myriadrf/LimeFEA-mPCIe/hardware/1v0/Project Outputs/Pics/Stack calc/0.32-0.7-0.32 copl outer 50.png

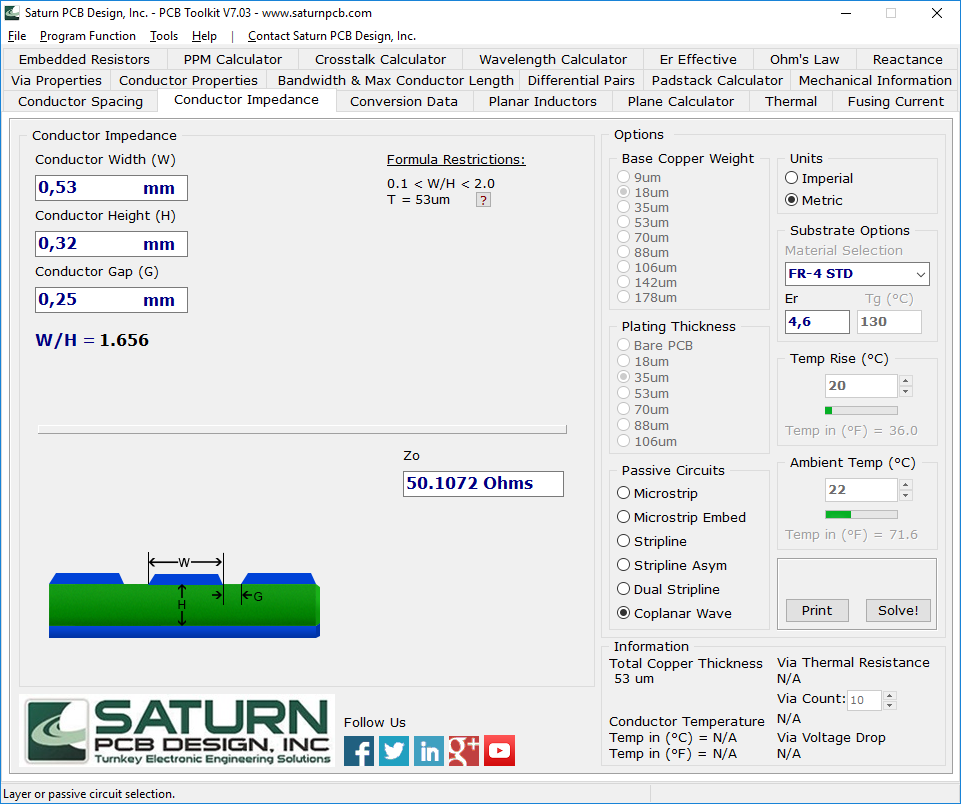
hardware/1v0/Project Outputs/Pics/Stack calc/0.32-0.7-0.32 copl outer 50.png
