myriadrf/LimeFEA-mPCIe/hardware/1v0/Project Outputs/Pics/Stack calc/0.32-0.7-0.32 strip inner 50.png

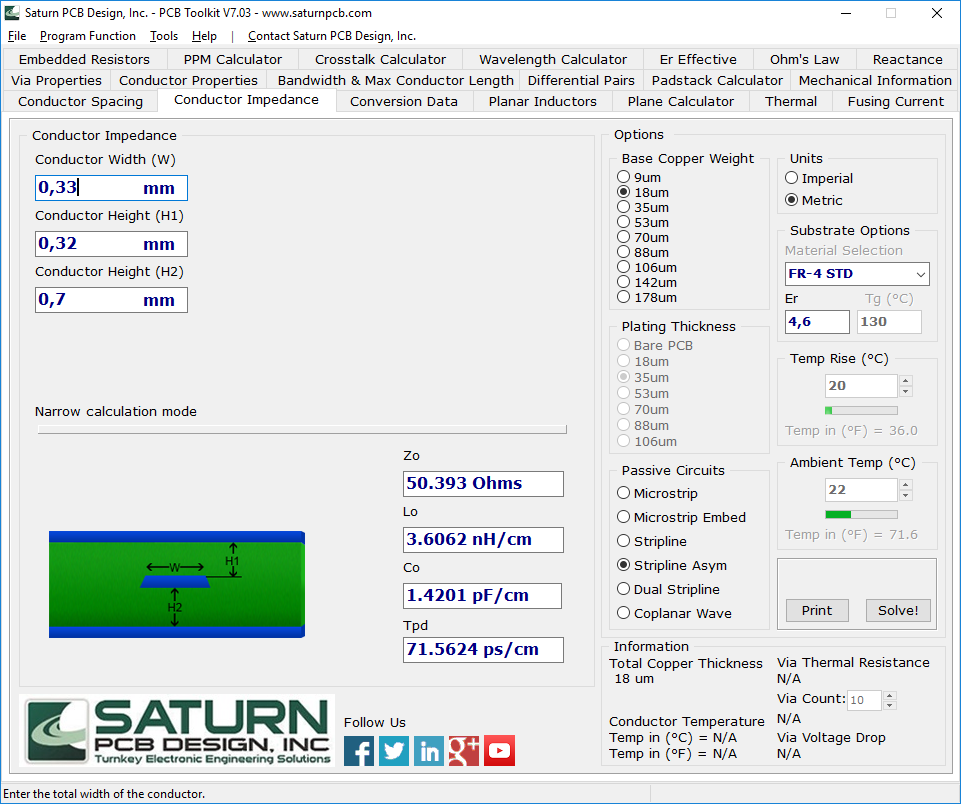
hardware/1v0/Project Outputs/Pics/Stack calc/0.32-0.7-0.32 strip inner 50.png
