myriadrf/LimeFEA-mPCIe/hardware/1v0/OutputJobs/BOM_Lime2.xlsx

Item # | Column=Comment | Column=Quantity | Column=Designator | Column=Description | Column=Comment | Column=Value | Column=U/P/TKE | Column=Name | Column=Designator | Column=Footprint | Column=Link | Column=Manufacturer | Column=Quantity
1
2
3
