myriadrf/LimeFEA-mPCIe/hardware/1v0/Project Outputs/BOM/BOM of 24070026 (LimeFEA-mPCIe_1v0) .xlsx

Reference Deal NO. |  | 24070026 |  |  |  | Orange: Need Special Attention
Part Number: |  | LimeFEA-mPCIe_1v0 |  | Green: Need Attention
Item | Qty | Reference | Manufacturer | Part No | Description |  | Note
1 | 6 | CJ1, CJ2, CJ5A, CJ5B, CJ6A, CJ6B | CHINA | AC-S01BH-U04RJ-F13-15 | Cable jumper |  | Substitutes
2 | 4 | CJ3A, CJ3B, CJ4A, CJ4B | CHINA | AC-U04RJ-U04RJ-F13-7.62 | Cable jumper |  | Substitutes
3 | 2 | 26B, C26A | YAGEO |  | CAP CER 1UF 10V X5R 0402
4 | 1 | C4 | YAGEO | SMD0603 | Capacitor |  | Substitutes
5 | 9 | C2, C3, C9, C10, C12, C15A, C15B, C18A, C18B | YAGEO | SMD0603 | Capacitor |  | Substitutes
6 | 4 | C23A, C23B, C24A, C24B | YAGEO | SMD0603 | Capacitor |  | Substitutes
7 | 1 | C1 | YAGEO | SMD0805 | Capacitor |  | Substitutes
8 | 1 | C11 | YAGEO | SMD0603 | Capacitor |  | Substitutes
9 | 1 | C7 | YAGEO | SMD0603 | Capacitor |  | Substitutes
10 | 18 | C13A, C13B, C14A, C14B, C16A, C16B, C17A, C17B, C19A, C19B, C20A, C20B, C21A, C21B, C22A, C22B, C25A, C25B | YAGEO | SMD0603 | Capacitor |  | Substitutes
11 | 1 | C8 | KEMET | CASE-D | Capacitor |  | Price based on T491D337K010AT
12 | 1 | E3 | / | Custom PCIe Bracket XTRX | CNC'ed enclosure component |  | Not quoted
13 | 1 | L2 | Taiyo | NRS5020T2R2NMGJ | Coil
14 | 1 | L3 | Taiyo | NRS5020T150MMGJ | Coil
15 | 4 | L4A, L4B, L5A, L5B | MURATA | LQW18AN22NG00D | Coil
16 | 12 | X3, X4, X11, X12, X13A, X13B, X14A, X14B, X15A, X15B, X16A, X16B | MOLEX | 734120110 | Connector (UMCC)
17 | 1 | X10 | MOLEX | 78864-1001 | Connector board to board
18 | 1 | X8 | Samtec | TSM-106-01-T-SH | Connector header male
19 | 1 | X1 | MOLEX | USB-microB | Connector microUSB-B
20 | 1 | X5 | JAE | MM60-52B1-G1 | Connector PCIe MiniCard |  | Price based on MM60-52B1-G1-R850
21 | 1 | X9 | JAE |  | Connector SIM micro card
22 | 4 | Z1A, Z1B, Z2A, Z2B | TDK | KNH16C105DB5TS | EMI Filter |  | Price based on YFF18PH0J105MT000N
23 | 1 | L1 | MURATA | BLM18PG181SN1D | Ferrite Bead EMIFIL
24 | 1 | X17 | CHINA |  | Headers & Wire Housings KK 100 Hdr FrLk Vert 02 Ckt Gold |  | Estimate, provide product images for the order
25 | 2 | U4A, U4B | Qorvo | SPF-5043Z | IC |  | Substitutes
26 | 1 | U1 | TI | TPS62130RG | IC
27 | 1 | U2 | onsemi | NCP5501DT50G | IC LDO fixed Vo
28 | 4 | U5A, U5B, U6A, U6B | Skyworks | SKY13286-359LF | IC RF SPDT Absorptive Switch
29 | 1 | J2` | YAGEO | SMD0603 | Jumper |  | Not fitted
30 | 2 | J1, J2 | Samtec | TSM-103-01-T-SH | Jumper 3 pin
31 | 2 | J1', J2' | CHINA | CYT1058 | Jumper Short Cup |  | Substitutes
32 | 2 | LED1, LED2 | LITE-ON | LTST-C190KGKT | LED GREEN
33 | 1 | LED3 | LITE-ON | LTST-C190KRKT | LED RED
34 | 2 | L6A, L6B | muRata |  | Power Inductors - SMD .22 UH 20% |  | LQW18ANR22G00D
35 | 1 | R6 | YAGEO | SMD0603 | Resistor
36 | 1 | R4 | YAGEO | SMD0603 | Resistor
37 | 1 | R5 | YAGEO | SMD0603 | Resistor
38 | 3 | R7, R8, R9 | YAGEO | SMD0603 | Resistor
39 | 2 | U3A, U3B | Qorvo |  | RF Amplifier .05-4GHz P1dB= 22dB Gain 26.4dB 5Volts
40 | 3 | Cover1, Cover2, Cover3 | Laird Technologies EMI | Screening shield cover BMI-S-202-C | Screening shield cover
41 | 3 | Shield1, Shield2, Shield3 | Laird Technologies EMI | Screening shield frame BMI-S-202-F | Screening shield frame
42 | 2 | E4, E5 | CHINA | AFBST090-440X532-000200 | Screw #4-40 |  | Substitutes
43 | 2 | E1, E2 | CHINA | ASMM19228 | Screw M2 |  | Substitutes
44 | 2 | X6, X7 | JAE | NT1R3000 | Stand-off nut PCIe MiniCard
45 | 1 | TG1 | Wakefield-Vette | PL-05-5-1016-H | Thermal gap filler
