myriadrf/LimeFEA-mPCIe/hardware/1v0/Project Outputs/LimeFEA-mPCIe_1v0_schematics.pdf

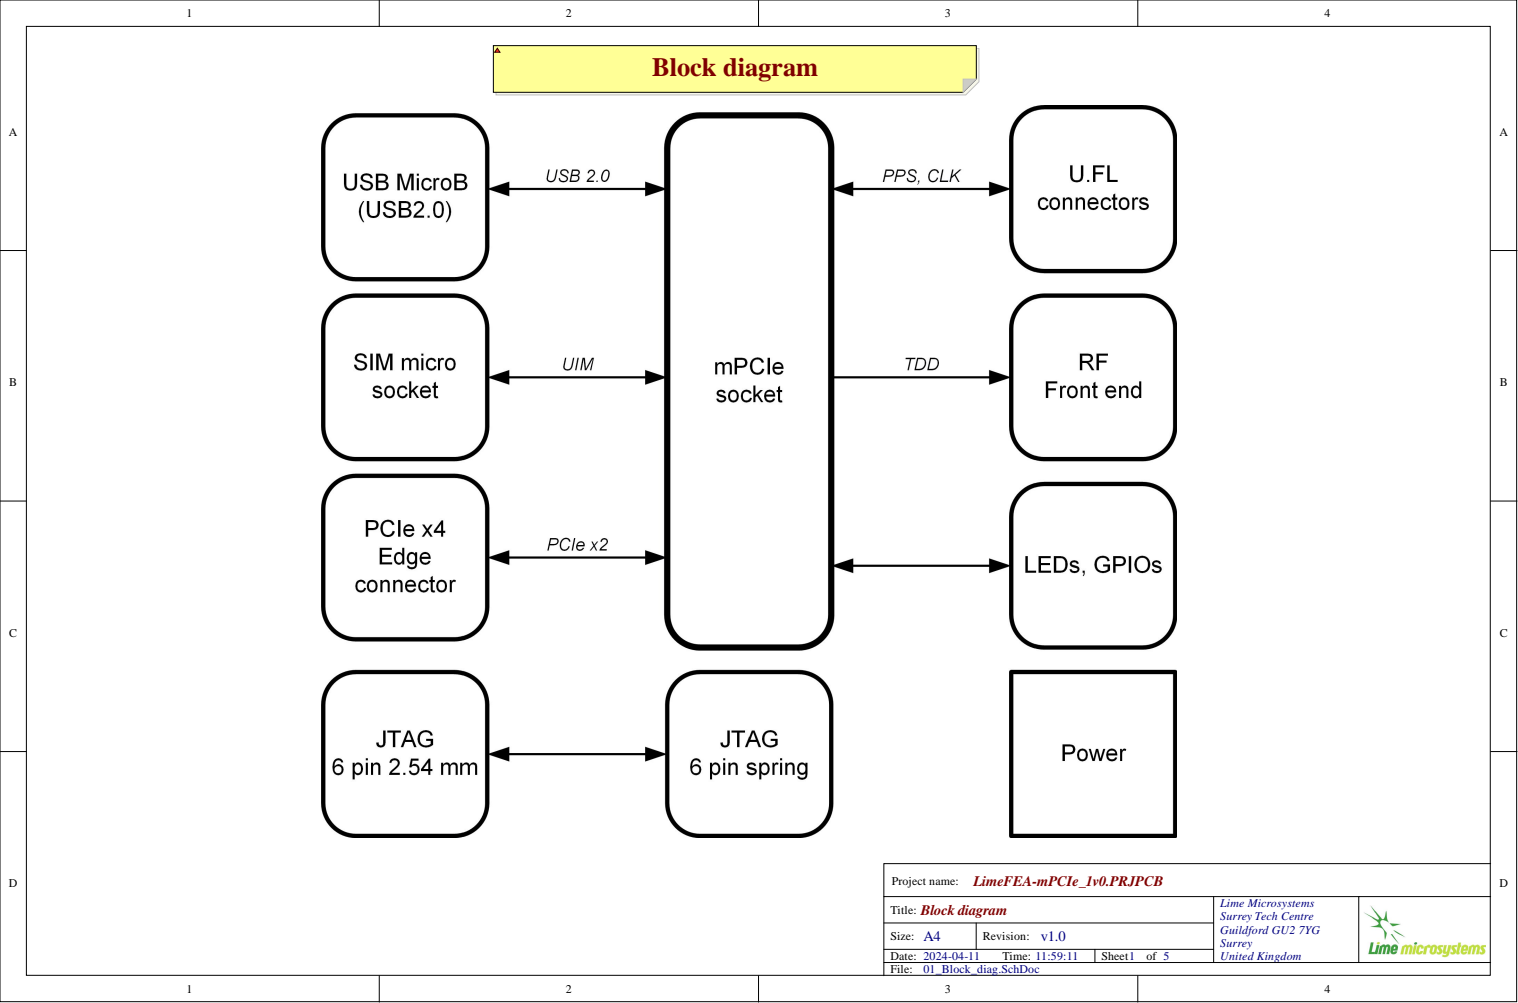
[picture p11: page 1]

Block diagram Title: | Lime Microsystems Surrey Tech Centre Guildford GU2 7YG Surrey United Kingdom

Size: A4 | Revision: v1.0
Date: 2024-04-11 Time: 11:59:11 | Sheet of 5

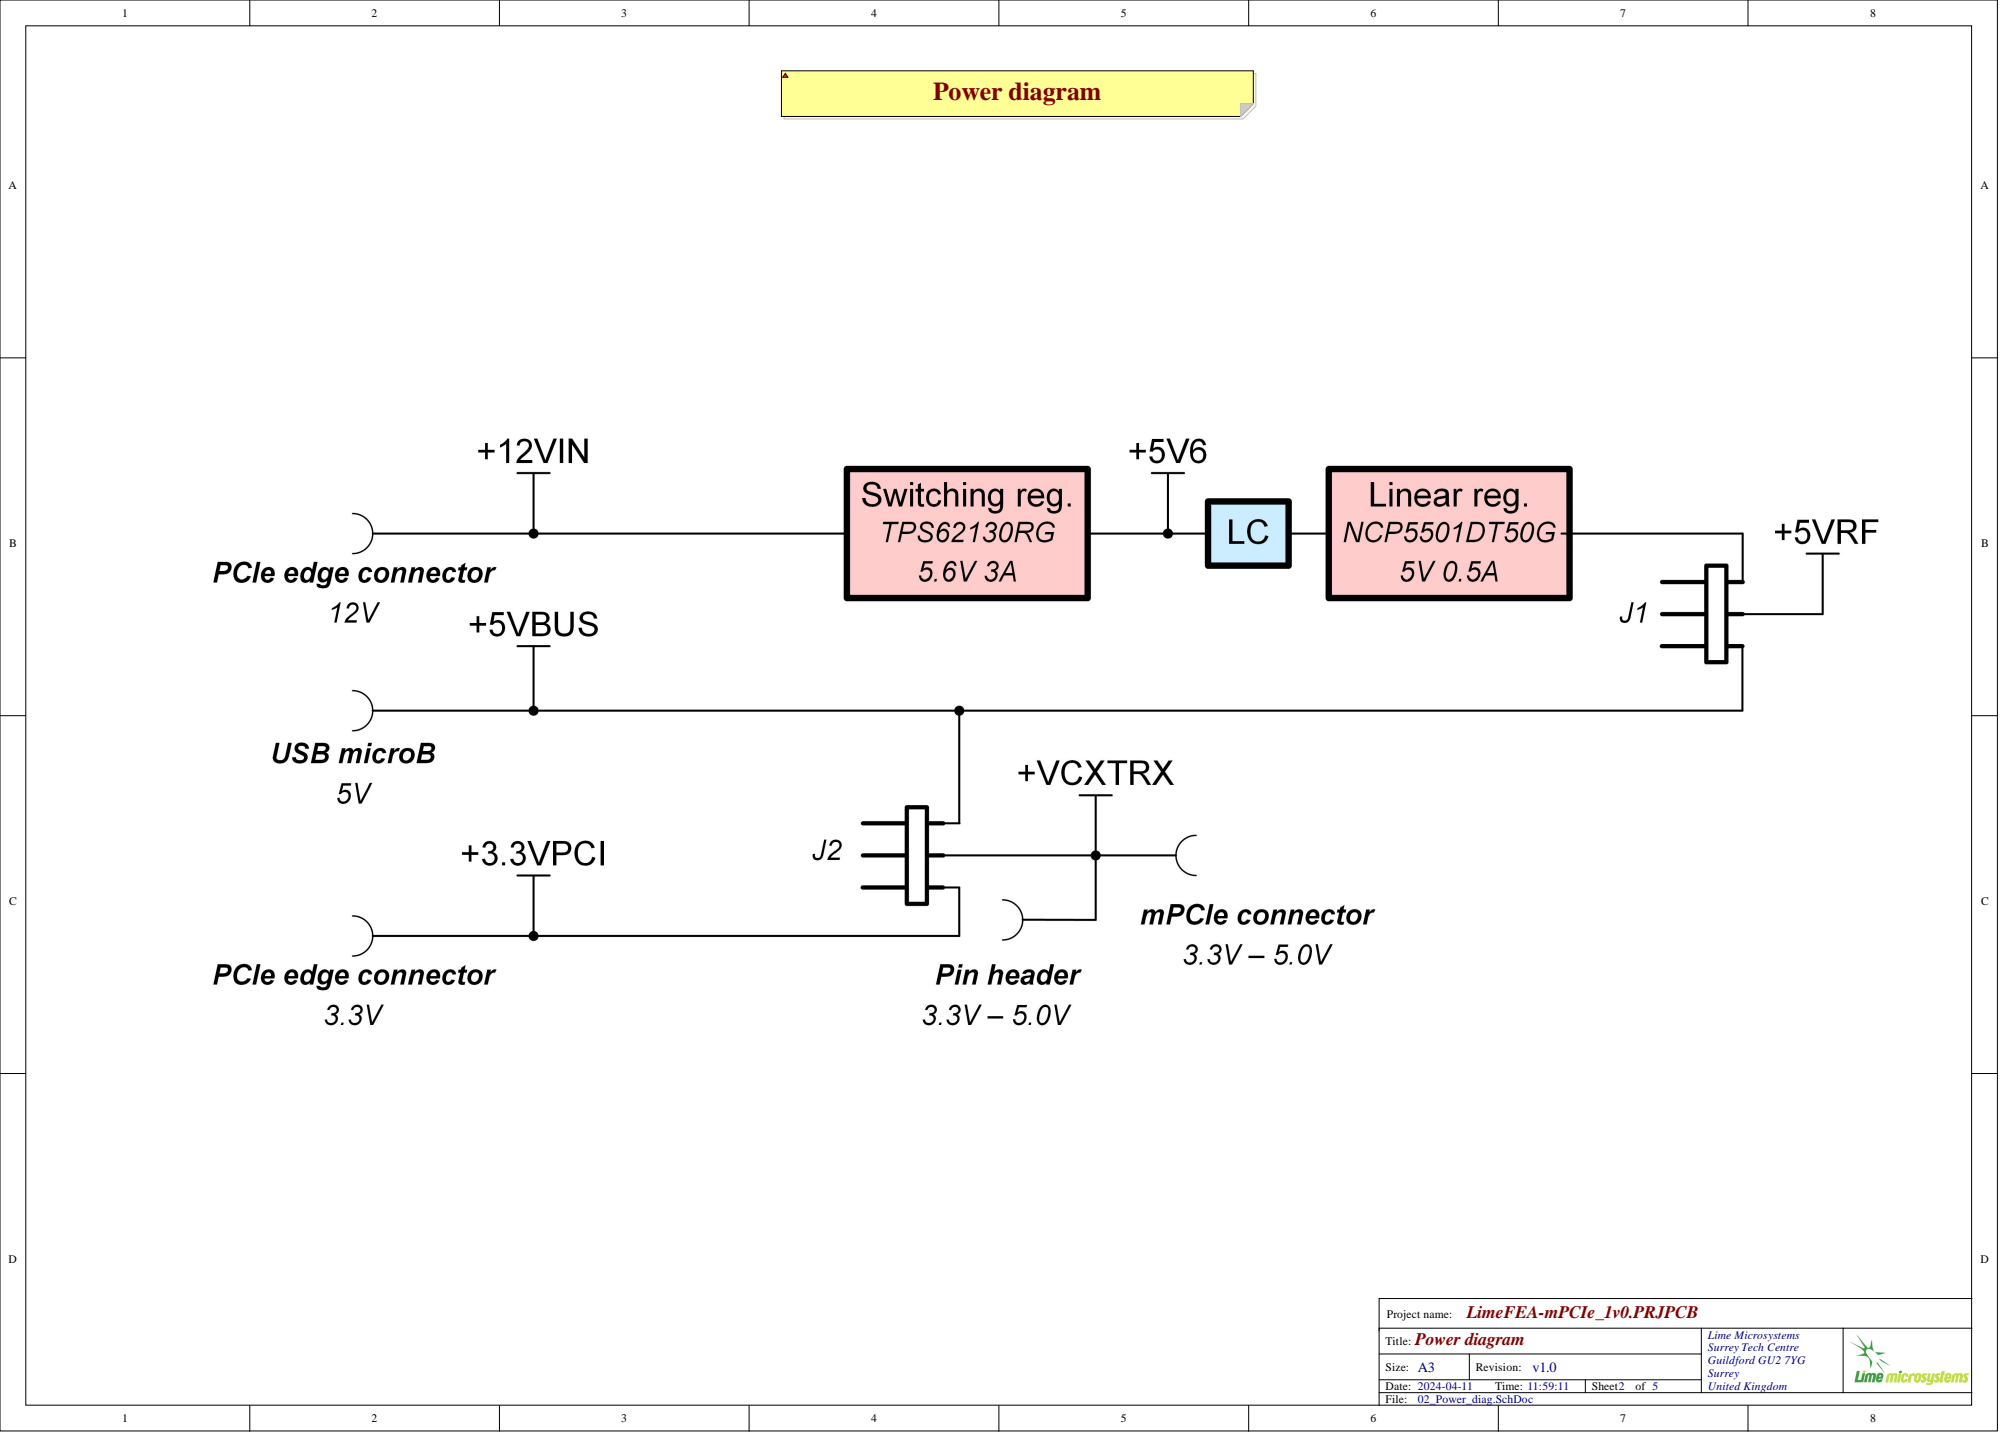
[picture p12: page 2]

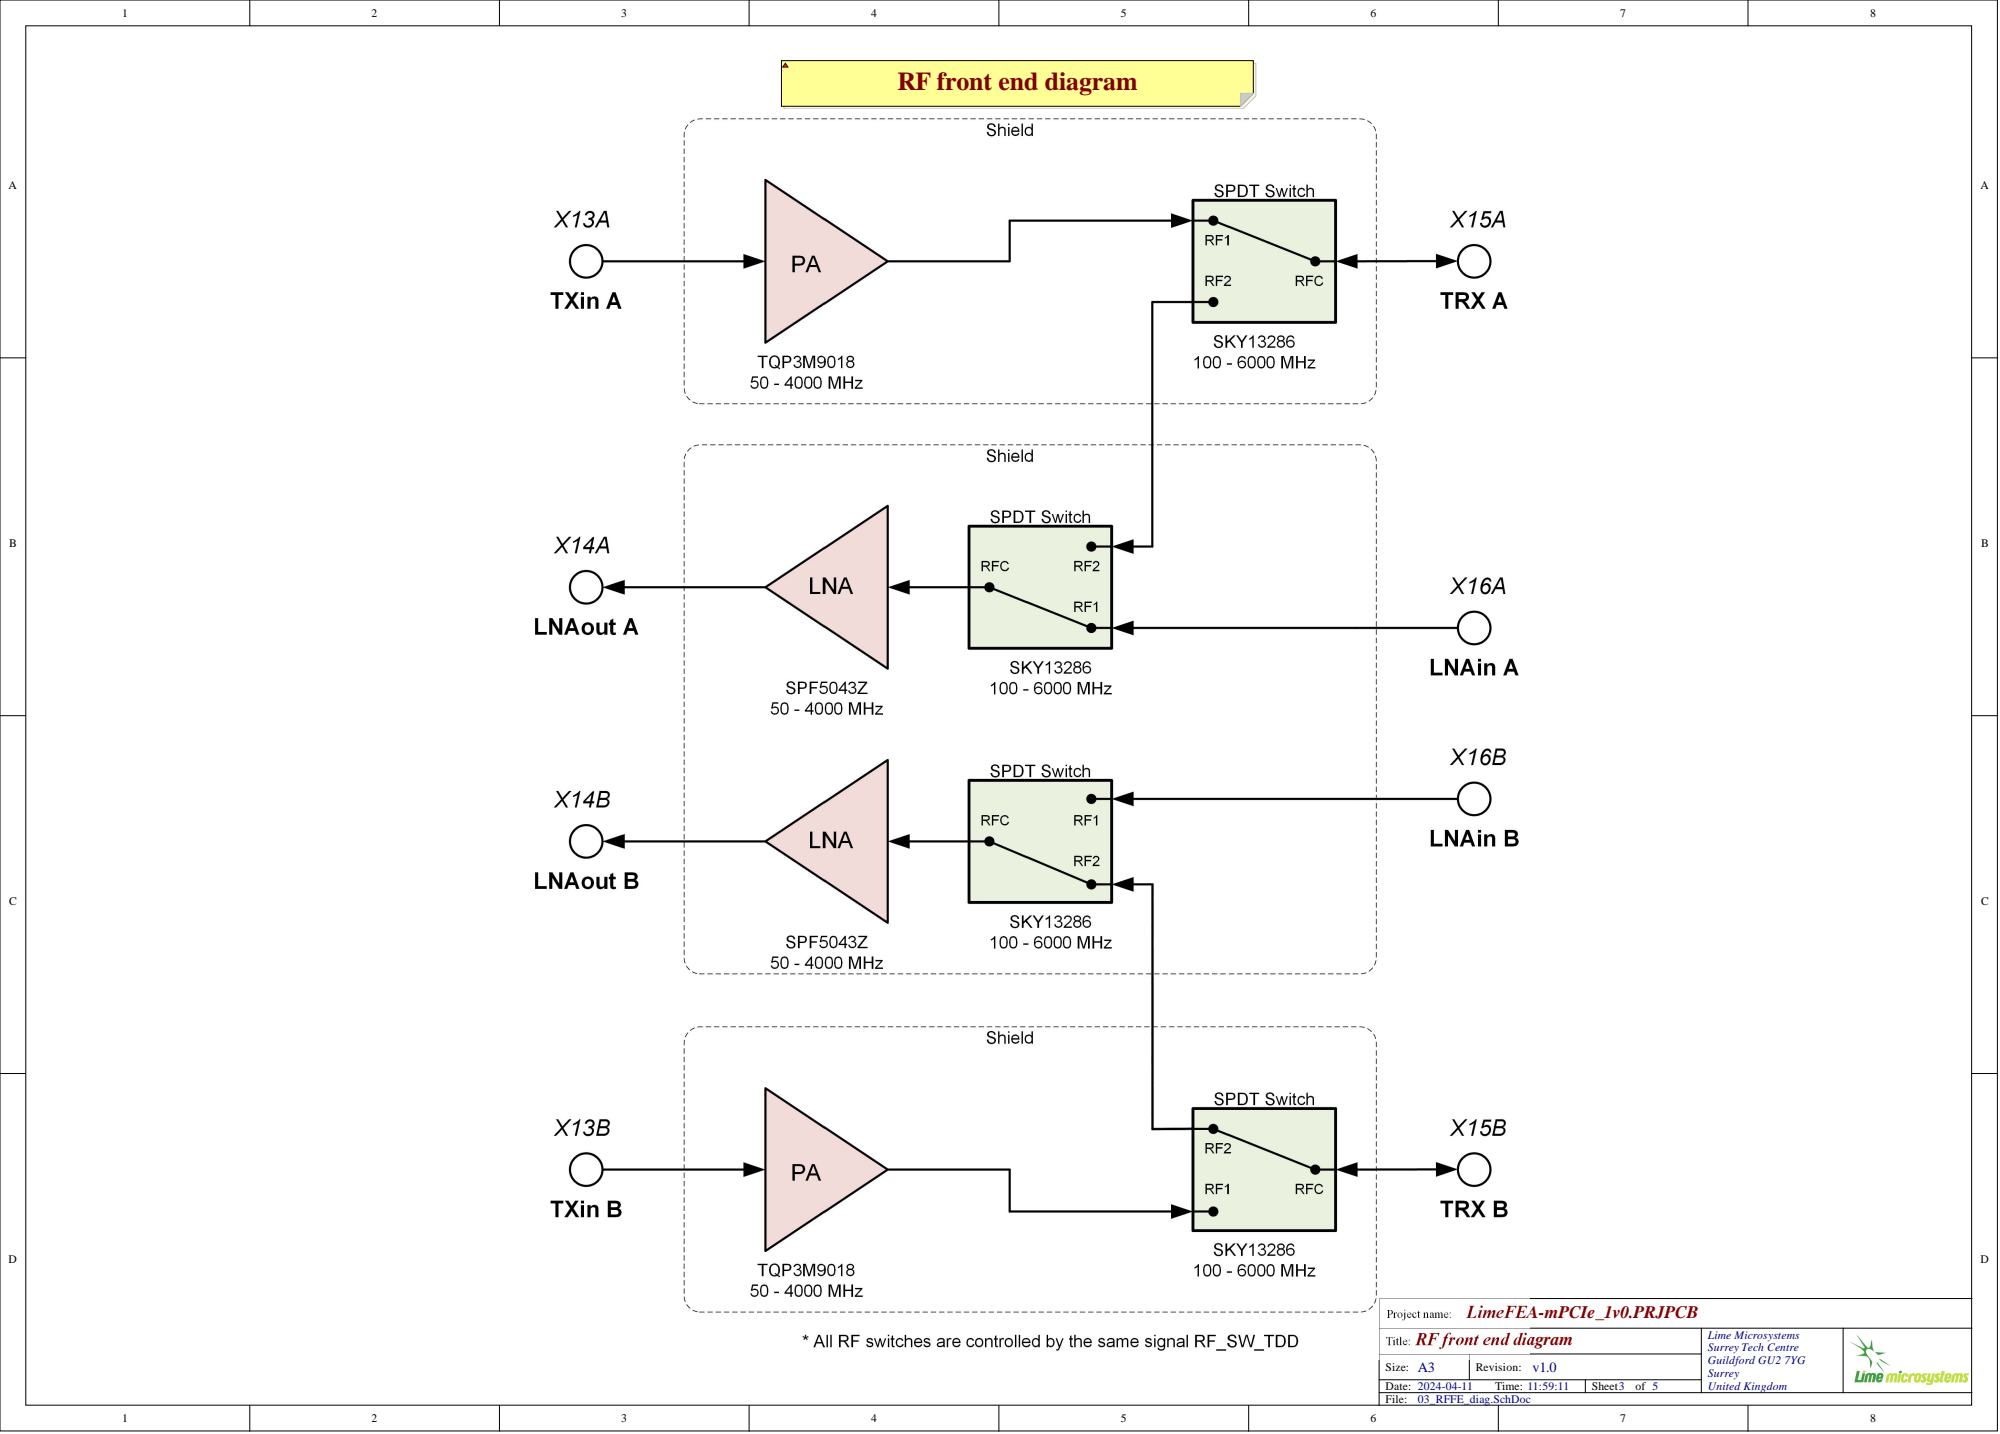
[picture p13: page 3]

RF front end diagram

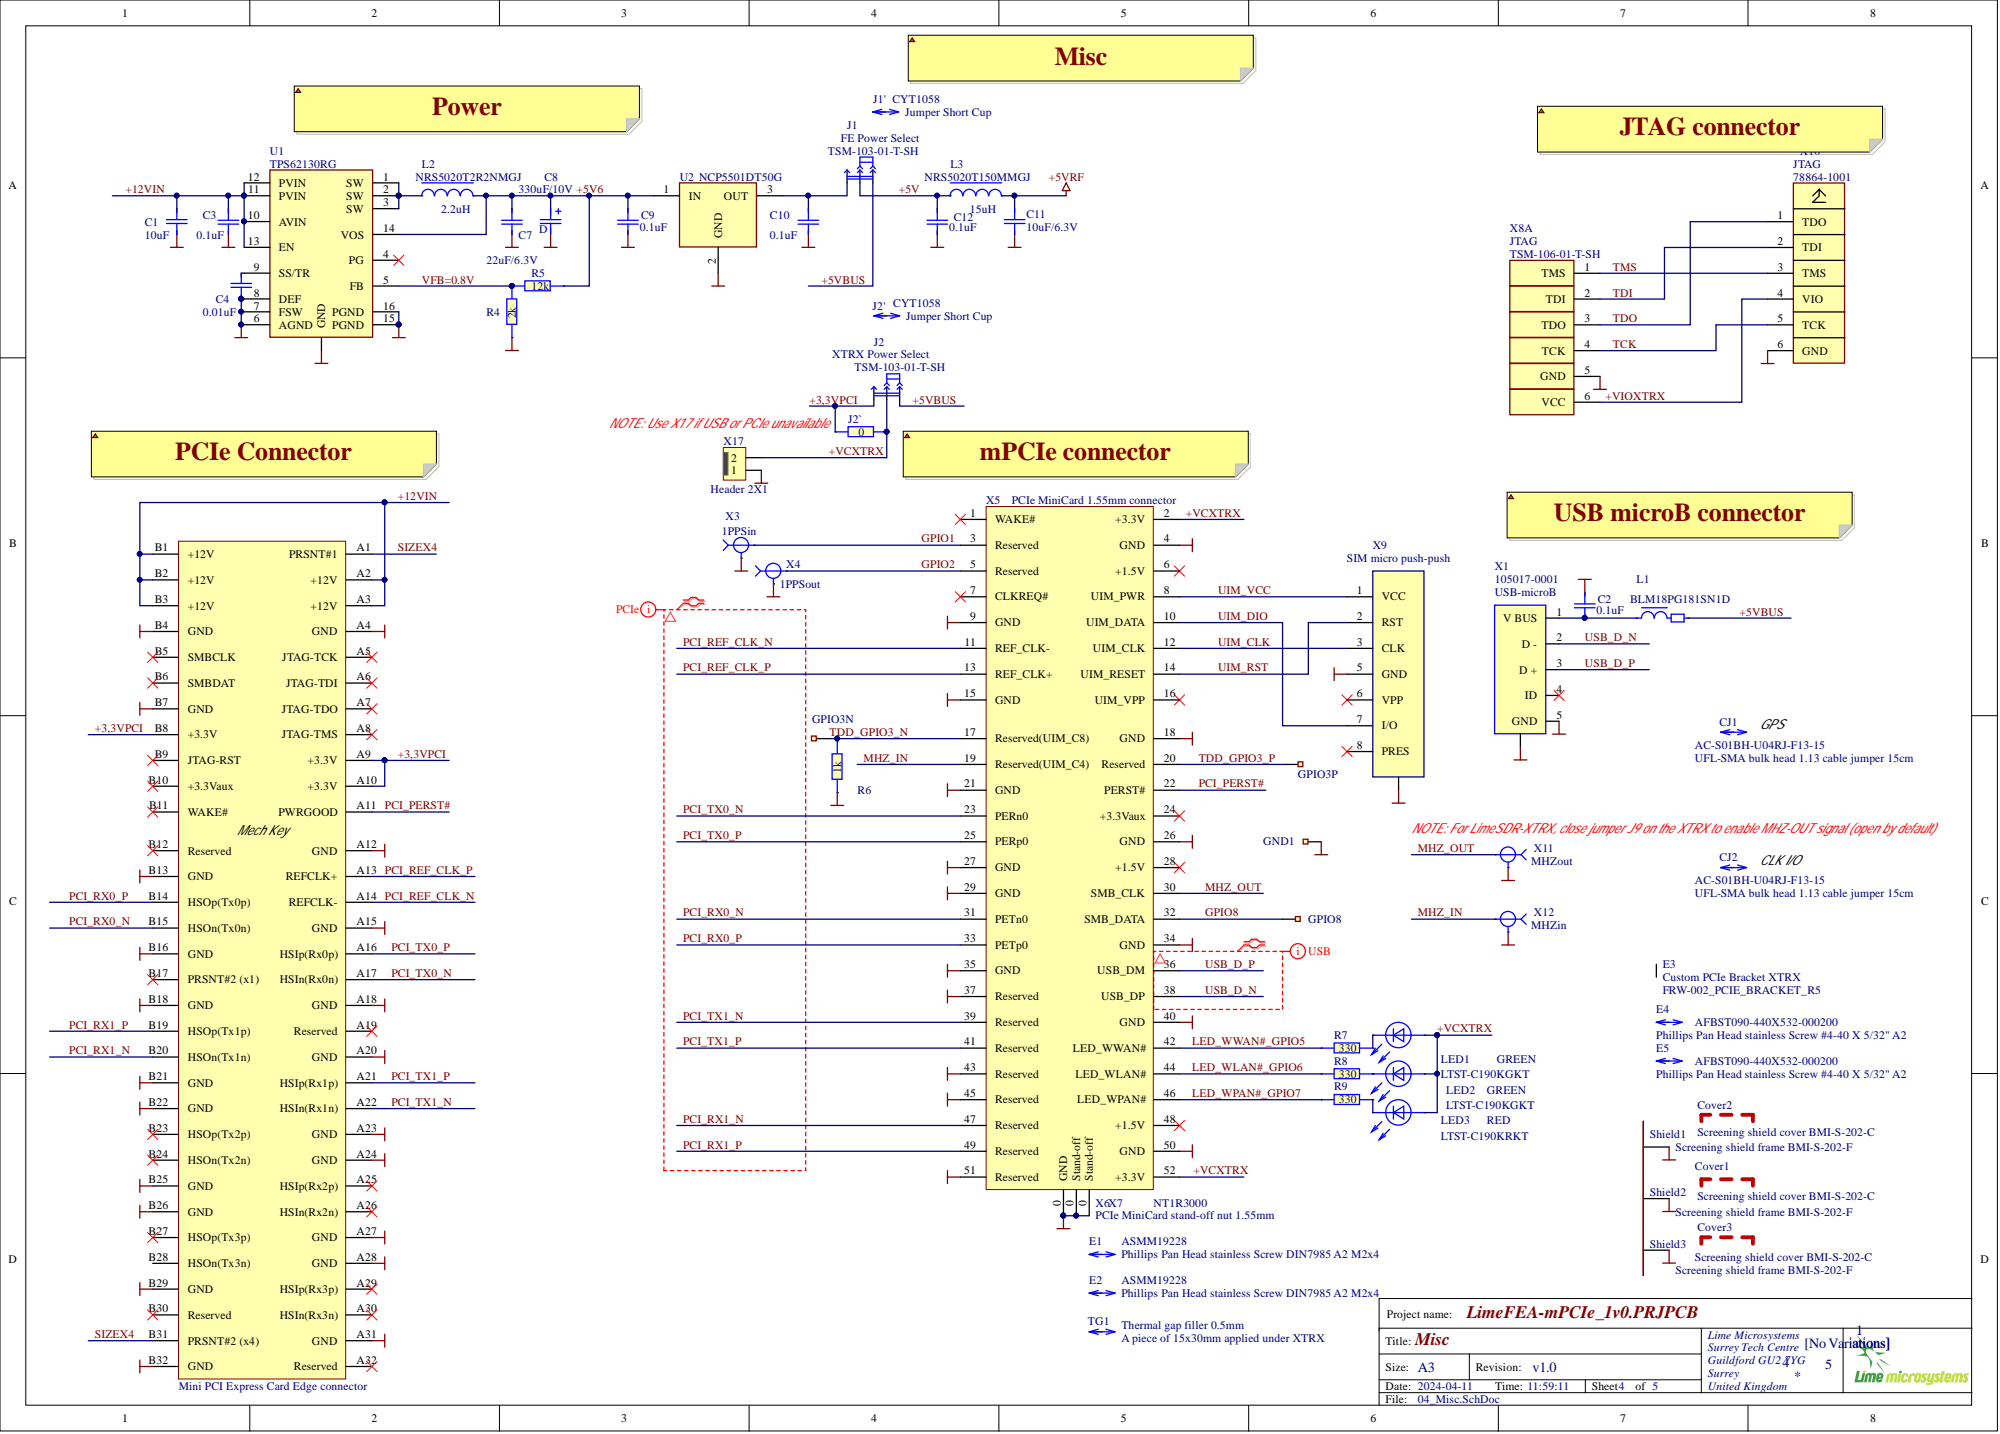
[picture p14: page 4]

NOTE: Use X17 if USB or PCIe unavailable

SIM micro push-push

RST 2

REF_CLK- 11 | UIM_CLK | CLK 3

UFL-SMA bulk head 1.13 cable jumper 15cm

NOTE: For LimeSDR-XTRX, close jumper J9 on the XTRX to enable MHZ-OUT signal (open by default)

Phillips Pan Head stainless Screw #4-40 X 5/32" A2

Screening shield cover BMI-S-202-C
Screening shield frame BMI-S-202-F
Cover1

PCIe MiniCard stand-off nut 1.55mm

Phillips Pan Head stainless Screw DIN7985 A2 M2x4

A piece of 15x30mm applied under XTRX

Mini PCI Express Card Edge connector

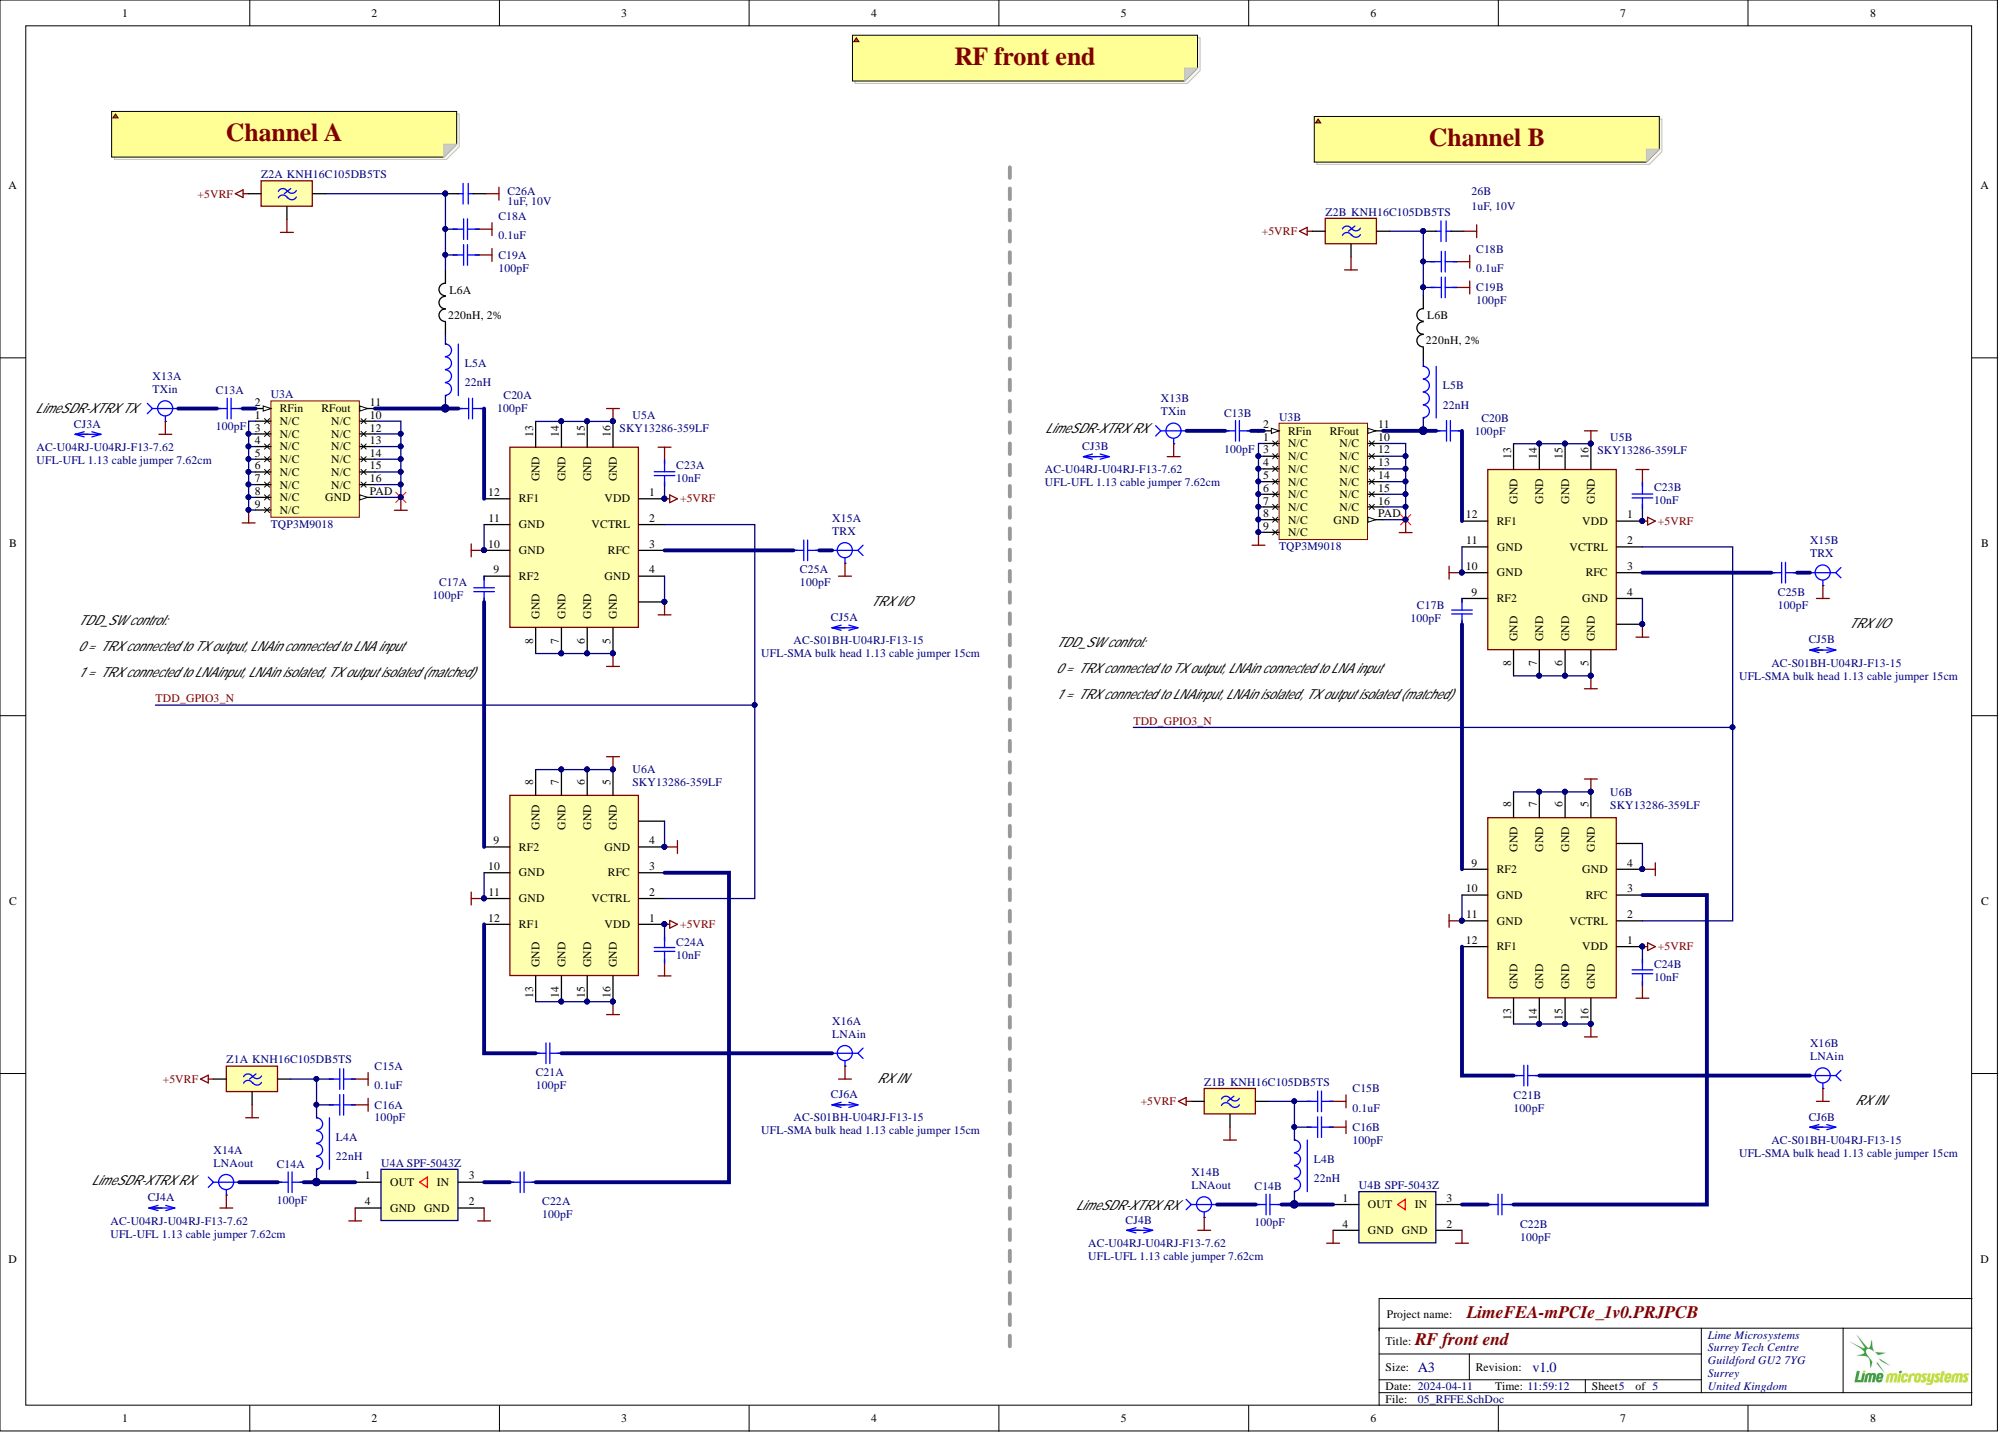
[picture p15: page 5]

TDD_SW control: 0 = TRX connected to TX output, LNAin con

nected to LNA in
LimeSDR-XTRX RX TDD_GPIO

put, LNAin isolated, TX output isolated (matched)

T i t le: RF front end | Li me M icro sys tem s S u r rey Tech Cen t re G u i l dfo rd G U2 7YG S u r rey Un i ted Ki n g d o m

A | Rev i s i o n : v 1.0
4-0 4-1 T ime: : : | Sheet o f
