myriadrf/LimeFEA-mPCIe/hardware/1v0/Project Outputs/LimeFEA-mPCIe_1v0_assembly.PDF

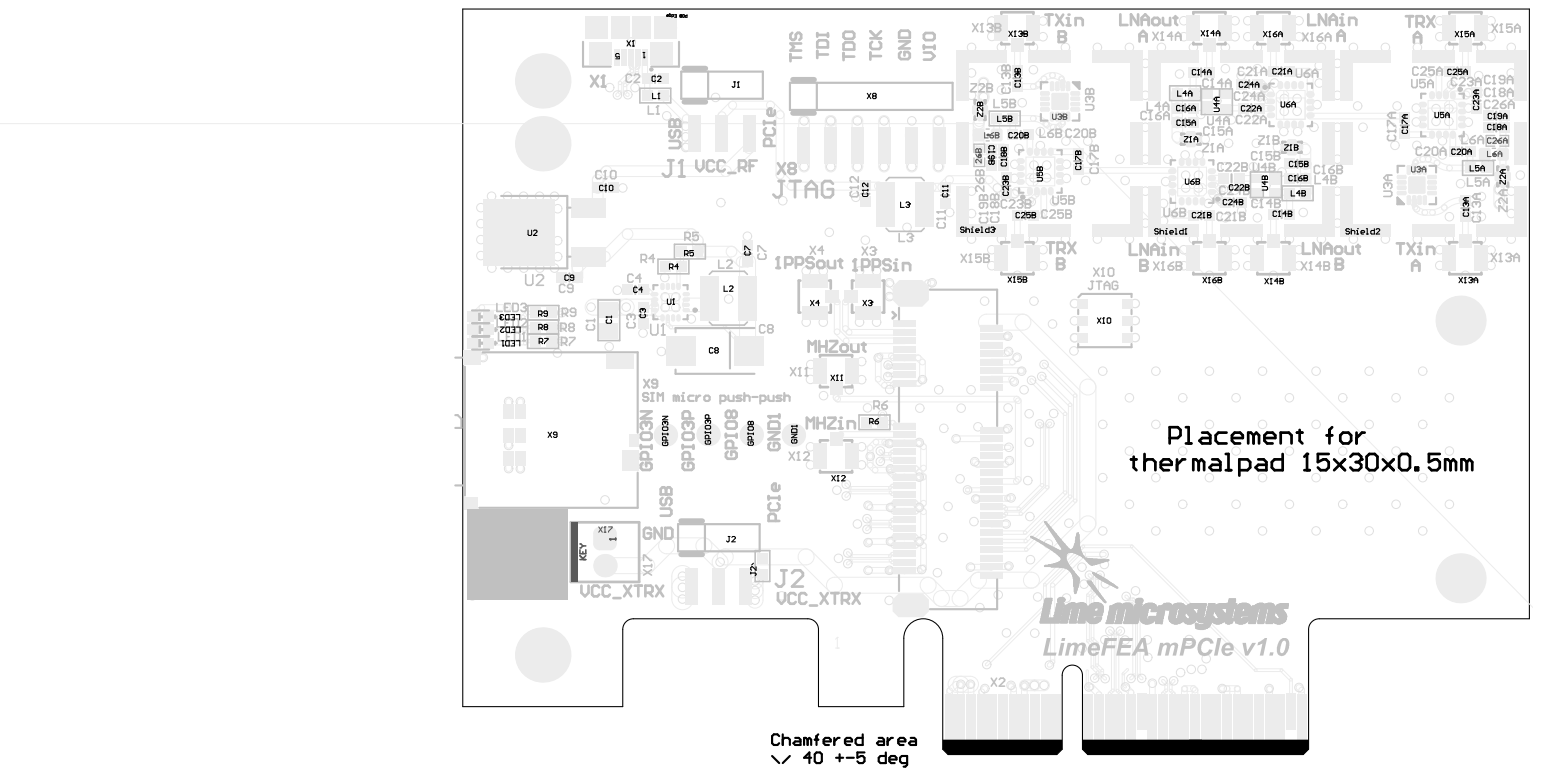
[picture p16: page 1]
