myriadrf/LimeFEA-mPCIe/(list of files, drawings)

Other design files:
hardware/1v0/LimeFEA-mPCIe_1v0.PRJPCB
hardware/1v0/Schematics/01_Block_diag.SchDoc
hardware/1v0/Schematics/02_Power_diag.SchDoc
hardware/1v0/Schematics/03_RFFE_diag.SchDoc
hardware/1v0/Schematics/04_Misc.SchDoc
hardware/1v0/Schematics/05_RFFE.SchDoc
