myriadrf/LimeFEA-mPCIe/(commit log)

2024-11-19 Added 1v0 Altium project files (Full and Lite)
    [01_Block_diag.SchDoc, 02_Power_diag.SchDoc, 03_RFFE_diag.SchDoc, 04_Misc.SchDoc, 05_RFFE.SchDoc, BOM of 24070026 (LimeFEA-mPCIe_1v0) .xlsx, BOM of 24070026 (LimeFEA-mPCIe_1v0_lite)_r1.xlsx, BOM_Lime2.xlsx]
2024-11-19 removed altium project files
    [01_Block_diag.SchDoc, 02_Power_diag.SchDoc, 03_RFFE_diag.SchDoc, 04_Misc.SchDoc, 05_RFFE.SchDoc, BOM of 24070026 (LimeFEA-mPCIe_1v0) .xlsx, BOM of 24070026 (LimeFEA-mPCIe_1v0_lite)_r1.xlsx, BOM_Lime2.xlsx]
2024-11-19 Initial project commit (merged from full and lite versions)
    [01_Block_diag.SchDoc, 02_Power_diag.SchDoc, 03_RFFE_diag.SchDoc, 04_Misc.SchDoc, 05_RFFE.SchDoc, BOM of 24070026 (LimeFEA-mPCIe_1v0) .xlsx, BOM of 24070026 (LimeFEA-mPCIe_1v0_lite)_r1.xlsx, BOM_Lime2.xlsx]
2024-11-25 fix board names
    removed minuses
2024-11-25 changed 'LimeSDR mPCIe Board Architecture' to 'LimeFEA mPCIe Board Architecture'
2025-08-18 Added PCB color notes
2025-08-19 Added PCB material comment
2025-08-19 Changed PCB material comment
    PCB top layer material - IT-180A preferred or equivalent RF-rated material (up to 3 GHz or higher)
2025-08-19 Added new DFM version with board color and pcb material notes
2025-08-19 added new lite DFM version with PCB color notes
2025-09-03 Changed thermal pad to Wurth 40016005
    [04_Misc.SchDoc]
